slogic3d-cloud/3d-printer/BOM.csv

Reference | Value | Footprint | Qty ordered | LCSC | Total (EUR) | Link | Notes
C1, C4 | 10u | 0805 | 20 | C15850 | 0.61 | https://www.lcsc.com/product-detail/C15850.html | JLCPCB Basic
C2 | 22u | 0805 | 9 | C45783 | 1.47 | https://www.lcsc.com/product-detail/C45783.html | JLCPCB Basic
C3, C5 | 100n | 0805 | 20 | C49678 | 0.37 | https://www.lcsc.com/product-detail/C49678.html | JLCPCB Basic
C6 | 1u | 0805 | 20 | C28323 | 0.50 | https://www.lcsc.com/product-detail/C28323.html | JLCPCB Basic
F1 | Polyfuse 500mA/24V | 1206 | 7 | C2984676 | 0.56 | https://www.lcsc.com/product-detail/C2984676.html | JLCPCB Extended
J1 | USB-C HRO TYPE-C-31-M-12 | USB_C_Receptacle_HRO_TYPE-C-31-M-12 | 5 | C165948 | 0.83 | https://www.lcsc.com/product-detail/C165948.html | JLCPCB Extended
Q1, Q2 | MMBT3904 | SOT-23 | 15 | C20526 | 0.16 | https://www.lcsc.com/product-detail/C20526.html | JLCPCB Basic
R1, R2 | 5.1k | 0603 | 20 | C23186 | 0.03 | https://www.lcsc.com/product-detail/C23186.html | JLCPCB Basic
R3, R4, R5 | 10k | 0603 | 25 | C25804 | 0.05 | https://www.lcsc.com/product-detail/C25804.html | JLCPCB Basic
SW1, SW2 | PTS645SK43SMTR92 | SW_SPST_PTS645Sx43SMTR92 | 10 | C221871 | 2.38 | https://www.lcsc.com/product-detail/C221871.html | JLCPCB Extended
U1 | AMS1117-3.3 | SOT-223-3_TabPin2 | 5 | C6186 | 0.92 | https://www.lcsc.com/product-detail/C6186.html | JLCPCB Basic
U2 | ESP32-WROOM-32UE-N4 | ESP32-WROOM-32U | 5 | C701344 | 17.85 | https://www.lcsc.com/product-detail/C701344.html | JLCPCB Extended
U3 | CH340C | SOIC-16_3.9x9.9mm_P1.27mm | 5 | C7464026 | 2.66 | https://www.lcsc.com/product-detail/C7464026.html | JLCPCB Extended
U4 | USBLC6-2SC6 | SOT-23-6 | 9 | C2687116 | 0.38 | https://www.lcsc.com/product-detail/C2687116.html | JLCPCB Extended
J2, J3 | Pin header 1x40 2.54mm (5 pcs; 2x19 used) | PinHeader_1x19_P2.54mm_Vertical | 5 |  | 5.69 | https://www.amazon.de/dp/B0GSDPFR2S | hand soldered; bought privately on Amazon.de (fast delivery) - not part of grant
ANT1 | 2.4/5 GHz 8dBi RP-SMA antenna + U.FL/IPEX to RP-SMA pigtail 21cm (2 pcs) | - | 2 |  | 8.99 | https://www.amazon.de/dp/B09K41BDYL | not on PCB; bought privately on Amazon.de - not part of grant
PCB | JLCPCB 2-layer purple 48.5x53mm lead-free HASL | - | 5 |  | 4.63 | https://jlcpcb.com
PCBA | Setup fee | - | 1 |  | 22.93 | https://jlcpcb.com | Standard PCBA (Economic does not support the ESP32-WROOM-32UE; Standard assembles all 5 boards)
PCBA | Stencil | - | 1 |  | 7.37 | https://jlcpcb.com
PCBA | Feeders loading fee (extended parts) | - | 1 |  | 19.33 | https://jlcpcb.com
PCBA | SMT assembly | - | 1 |  | 1.21 | https://jlcpcb.com
PCBA | Packaging fee | - | 1 |  | 0.45 | https://jlcpcb.com
Shipping | JLCPCB Global Standard Direct Line | - | 1 |  | 8.78 | https://jlcpcb.com | 9-11 business days
Coupon | JLCPCB | - | 1 |  | -8.91 | https://jlcpcb.com
TOTAL |  |  |  |  | 84.49 |  | JLCPCB cart 2026-11-06 (merchandise 84.62 + shipping 8.78 - coupon 8.91); Standard PCBA x5 (minimum)
