slogic3d-cloud/3d-printer/PCB/production/bom.csv

Designator | Footprint | Quantity | Value | LCSC Part #
C1, C4 | 0805 | 2 | 10u
C2 | 0805 | 1 | 22u
C3, C5 | 0805 | 2 | 100n
C6 | 0805 | 1 | 1u
F1 | 1206 | 1 | Fuse
J1 | USB_C_Receptacle_HRO_TYPE-C-31-M-12 | 1 | USB_C_Receptacle_USB2.0_16P
J2, J3 | PinHeader_1x19_P2.54mm_Vertical | 2 | Conn_01x19_Pin
Q1, Q2 | SOT-23 | 2 | Q_NPN_BEC
R1, R2 | 0603 | 2 | 5.1k
R3, R4, R5 | 0603 | 3 | 10k
SW1, SW2 | SW_SPST_PTS645Sx43SMTR92 | 2 | SW_Push
U1 | SOT-223-3_TabPin2 | 1 | AMS1117-3.3
U2 | ESP32-WROOM-32U | 1 | ESP32-WROOM-32UE
U3 | SOIC-16_3.9x9.9mm_P1.27mm | 1 | CH340C
U4 | SOT-23-6 | 1 | USBLC6-2SC6
