slogic3d-cloud/3d-printer/PCB/DEV-Board-Based-on-ESP32.step

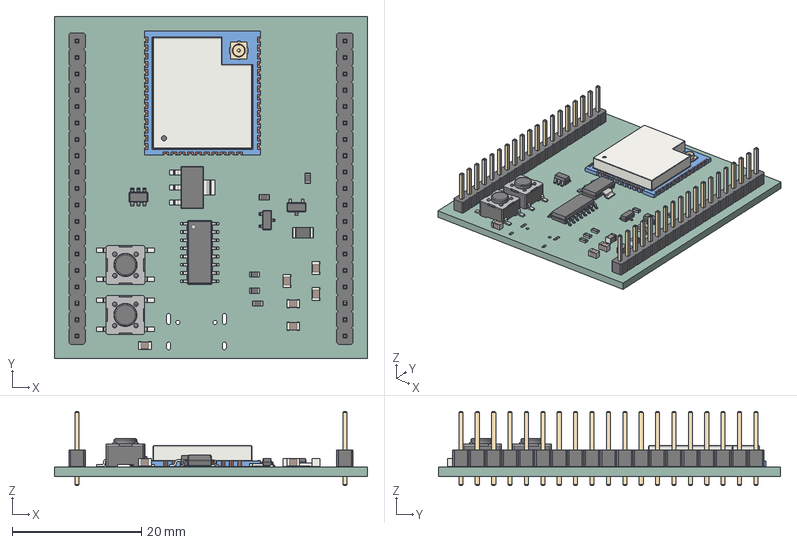
[picture p1: CAD file, 2026-11-06]
PCB/DEV-Board-Based-on-ESP32.step
48.5 x 53.0 x 11.5 mm
R_0603_1608Metric x 5
SW_SPST_PTS645Sx43SMTR92 x 2
SOT-23 x 2
C_0805_2012Metric x 6
SOT-23-6
ESP32-WROOM-32U
PinHeader_1x19_P254mm_Vertical x 2
SOIC-16_3.9x9.9mm_P1.27mm
SOT-223
Fuse_1206_3216Metric
DEV3F8A_PCB
