slogic3d-cloud/3d-printer/PCB/DEV-Board-Based-on-ESP32.kicad_pcb

## KiCad design PCB/DEV-Board-Based-on-ESP32.kicad_pcb (2026-11-06)

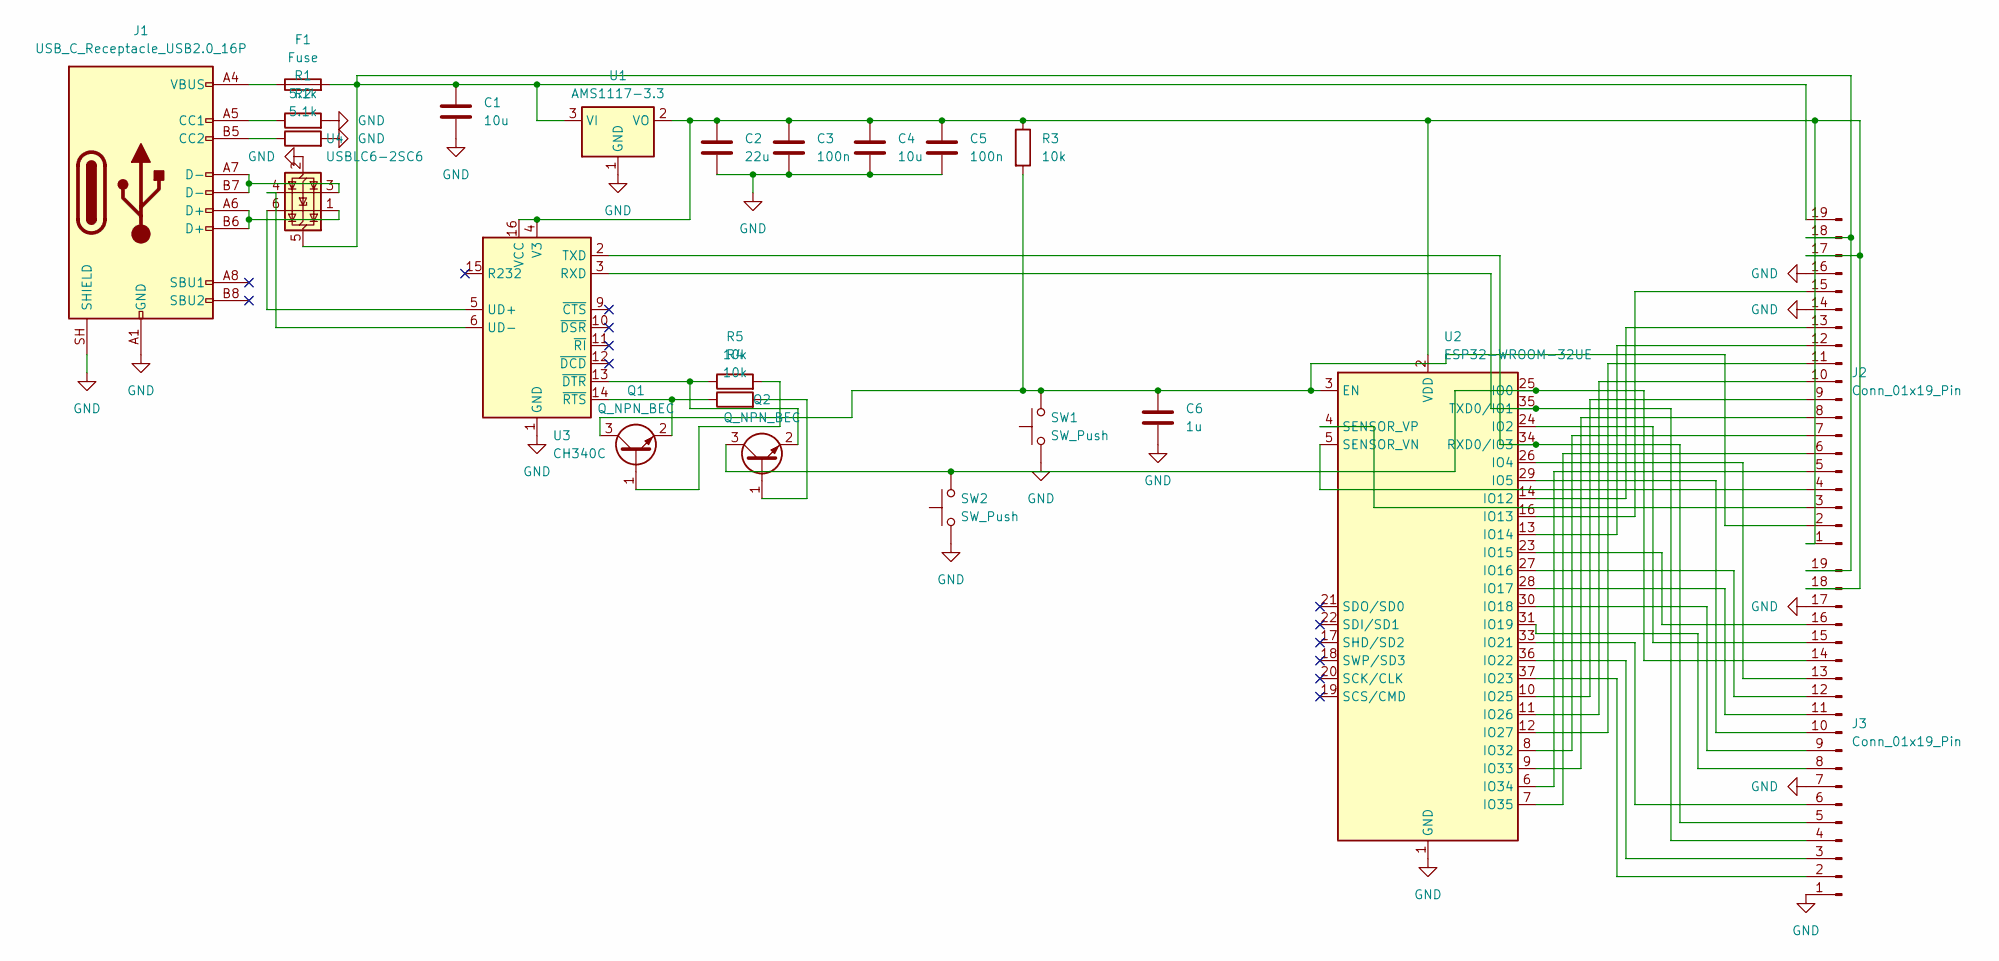
[picture p2: schematic DEV-Board-Based-on-ESP32.kicad_sch]

Parts:
C1, C4: 10u; C_0805_2012Metric
C2: 22u; C_0805_2012Metric
C3, C5: 100n; C_0805_2012Metric
C6: 1u; C_0805_2012Metric
F1: Fuse; Fuse_1206_3216Metric
J1: USB_C_Receptacle_USB2.0_16P; USB_C_Receptacle_HRO_TYPE-C-31-M-12
J2, J3: Conn_01x19_Pin; PinHeader_1x19_P2.54mm_Vertical
Q1, Q2: Q_NPN_BEC; SOT-23
R1, R2: 5.1k; R_0603_1608Metric
R3, R4, R5: 10k; R_0603_1608Metric
SW1, SW2: SW_Push; SW_SPST_PTS645Sx43SMTR92
U1: AMS1117-3.3; SOT-223-3_TabPin2
U2: ESP32-WROOM-32UE; ESP32-WROOM-32U
U3: CH340C; SOIC-16_3.9x9.9mm_P1.27mm
U4: USBLC6-2SC6; SOT-23-6

Connections:
GND: C1.2, C2.2, C3.2, C4.2, C5.2, C6.2, J1.A1 (GND), J1.A12 (GND), J1.B1 (GND), J1.B12 (GND), J1.SH (SHIELD), J2.14, J2.16, J3.1, J3.7, J3.17, R1.2, R2.2, SW1.1, SW2.1, U1.1 (GND), U2.1 (GND), U2.15 (GND), U2.38 (GND), U2.39 (GND), U3.1 (GND), U4.2 (GND)
unnamed: F1.1, J1.A4 (VBUS), J1.A9 (VBUS), J1.B4 (VBUS), J1.B9 (VBUS)
unnamed: J1.A5 (CC1), R1.1
unnamed: J1.B5 (CC2), R2.1
unnamed: J1.A6 (D+), J1.B6 (D+), U4.1 (I/O1)
unnamed: J1.A7 (D-), J1.B7 (D-), U4.3 (I/O2)
unnamed: C2.1, C3.1, C4.1, C5.1, J2.1, J2.17, J3.18, R3.1, U1.2 (VO), U2.2 (VDD), U3.4 (V3), U3.16 (VCC)
unnamed: C6.1, J2.2, Q1.3 (C), R3.2, SW1.2, U2.3 (EN)
unnamed: J2.3, U2.4 (SENSOR_VP)
unnamed: J2.4, U2.5 (SENSOR_VN)
unnamed: J2.5, U2.6 (IO34)
unnamed: J2.6, U2.7 (IO35)
unnamed: J2.7, U2.8 (IO32)
unnamed: J2.8, U2.9 (IO33)
unnamed: J2.9, U2.10 (IO25)
unnamed: J2.10, U2.11 (IO26)
unnamed: J2.11, U2.12 (IO27)
unnamed: J2.12, U2.13 (IO14)
unnamed: J2.13, U2.14 (IO12)
unnamed: J2.15, U2.16 (IO13)
unnamed: C1.1, F1.2, J2.18, J2.19, J3.19, U1.3 (VI), U4.5 (VBUS)
unnamed: J3.2, U2.37 (IO23)
unnamed: J3.3, U2.36 (IO22)
unnamed: J3.4, U2.35 (TXD0/IO1), U3.3 (RXD)
unnamed: J3.5, U2.34 (RXD0/IO3), U3.2 (TXD)
unnamed: J3.6, U2.33 (IO21)
unnamed: J3.8, U2.31 (IO19)
unnamed: J3.9, U2.30 (IO18)
unnamed: J3.10, U2.29 (IO5)
unnamed: J3.11, U2.28 (IO17)
unnamed: J3.12, U2.27 (IO16)
unnamed: J3.13, U2.26 (IO4)
unnamed: J3.14, Q2.3 (C), SW2.2, U2.25 (IO0)
unnamed: J3.15, U2.24 (IO2)
unnamed: J3.16, U2.23 (IO15)
unnamed: Q1.1 (B), R5.2
unnamed: Q1.2 (E), R4.1, U3.14 (~RTS)
unnamed: Q2.1 (B), R4.2
unnamed: Q2.2 (E), R5.1, U3.13 (~DTR)
unnamed: U3.5 (UD+), U4.6 (I/O1)
unnamed: U3.6 (UD-), U4.4 (I/O2)

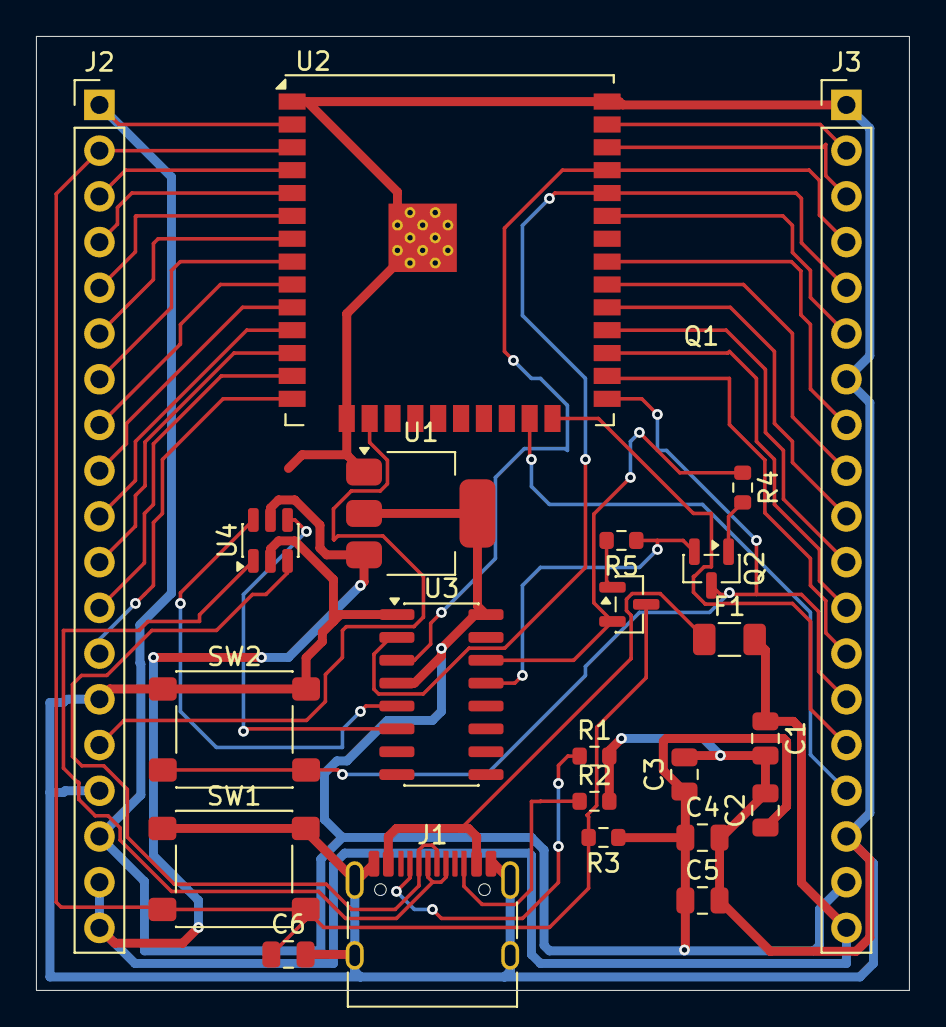
[picture p3: board DEV-Board-Based-on-ESP32.kicad_pcb from above]

Board: 2 copper layers, 48.5 x 53.0 mm, 23 parts (0 on the bottom side), 41 nets.
