slogic3d-cloud/3d-printer/JOURNAL.md

---
title: "Amethyst"
github: "https://github.com/slogic3d-cloud/dev-board"
description: "a developer board with usb-c and 38 pins"
created_at: "2026-11-05"
total_time: "7.5h"
---

## 05.11.2026: Starting
I created the schematics and the board so I started but didn't finished it at the same day.
Now I spent over four and a half hours and a lot of nerves on it.
The PCB was an annoying part of the project but at least i had fun.




 When i started, i made the following mistakes.
 Connected wrong pins together at the schematics.
 Too small tracs on the PCB for GND, 3.3V and 5V.
 I learned that it isn't good because of the temperature. The traces could melt.

## 06.11.2026: Finishing and correcting
I made the PCB new because of some mistakes.
It took me over 3 hours but not as many nerves as yesterday.
Today I didn't have fun with it because the music was missing.
In short I improved the conductive tracks for 3.3V, 5V and GND.



After a short break I exported the .step and the gerber files. 
I ran a final DRC with no errors and now I finished it in KiCad 10.0 .
The paperwork is being done right now, but the time is not counted.
