slogic3d-cloud/3d-printer/(commit log)

2026-11-02 Drop printer project, start simple-device interview notes
    Claude-Session: https://claude.ai/code/session_019isHHVywCPGnSkckYXrcU9
2026-11-02 Interview progress 60/120: RP2040 board, PC app settings
    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
2026-11-02 Interview progress 80/120: enclosure, PCB, firmware behavior
    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
2026-11-02 Finish interview, remove printer notes, add project folders and BOM estimate
    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
2026-11-05 Switch to ESP32 dev board: move KiCad files to PCB/, add CC BY-NC-SA license, update notes
    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
    [DEV-Board-Based-on-ESP32.kicad_pcb, DEV-Board-Based-on-ESP32.kicad_sch]
2026-11-05 Add Fabricate repo structure: gitignore, BOM.csv skeleton
    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
    [BOM.csv]
2026-11-05 Remove empty CAD folder
    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
2026-11-05 Move updated KiCad files into PCB/
    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
    [DEV-Board-Based-on-ESP32.kicad_pcb, DEV-Board-Based-on-ESP32.kicad_sch]
2026-11-05 Add formatted PINOUT.md, update BOM.csv to new schematic, update notes
    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
    [BOM.csv]
2026-11-06 Update PCB: board outline, 0.5mm power traces, vias, all nets routed
    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
    [DEV-Board-Based-on-ESP32.kicad_pcb]
2026-11-06 Add STEP 3D model of the board
    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
    [DEV-Board-Based-on-ESP32.step]
2026-11-06 Add Gerber and drill files (gerbers.zip)
    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
    [DEV-Board-Based-on-ESP32.kicad_pcb]
2026-11-06 PCB: enlarge ESP32 thermal via drills to 0.3mm (DRC fixes)
    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
    [DEV-Board-Based-on-ESP32.kicad_pcb]
2026-11-06 Update gerbers.zip (0.3mm min drill)
    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
2026-11-06 Update JOURNAL.md
    rechtschreibung und grammar
2026-11-06 Add JLC assembly files (BOM, CPL, IPC netlist) from Fabrication Toolkit
    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
    [bom.csv, positions.csv]
2026-11-06 BOM: add JLCPCB prices, LCSC numbers and links from quote
    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
    [BOM.csv]
2026-11-06 BOM: note why Standard PCBA is used
    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
2026-11-06 BOM: explain Standard PCBA x5
    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
    [BOM.csv]
2026-11-06 BOM: final cart total with Global Standard shipping
    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
    [BOM.csv]
2026-11-06 BOM: antenna and pin headers bought privately
    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
    [BOM.csv]
2026-11-06 BOM: add privately bought antenna and pin headers
    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
    [BOM.csv]
2026-11-06 BOM: replace antenna with 2.4GHz U.FL pigtail kit
    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
    [BOM.csv]
